DBG-Robots/PI5-HAT-relocator/production/bom.csv

Designator | Footprint | Quantity | Value | LCSC Part #
J1, J11, J13, J15, J3, J5, J7, J9 | PinHeader_1x02_P2.54mm_Vertical | 8 | Conn_01x02_Pin
J10, J12, J14, J16, J2, J4, J6, J8 | PinSocket_1x02_P2.54mm_Vertical | 8 | Conn_01x02_Socket
