DBG-Robots/PI5-HAT-relocator/PI5-HAT-relocator.step

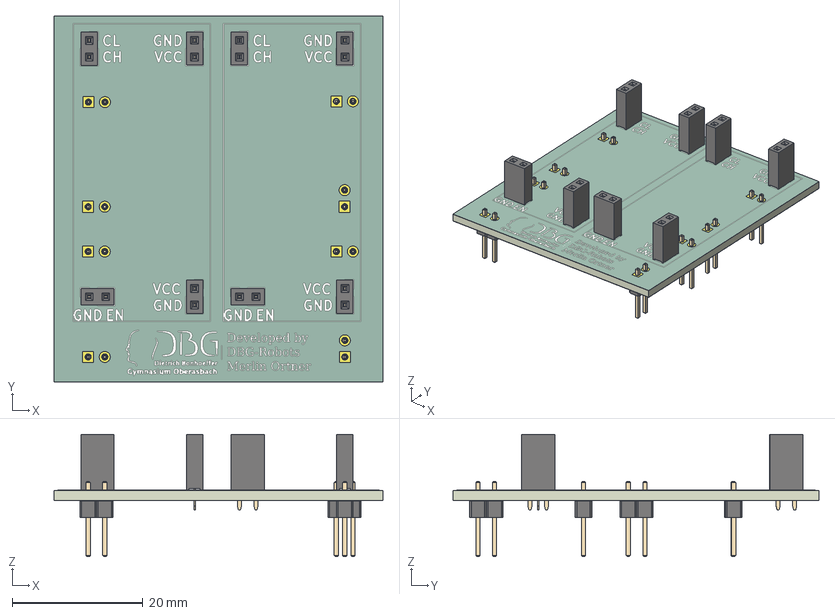
[picture p3: CAD file, 2026-10-31]
PI5-HAT-relocator.step
50.3 x 56.0 x 18.7 mm
PinSocket_1x02_P2.54mm_Vertical x 8
PinHeader_1x02_P254mm_Vertical x 8
MotorControllerHeader_copper
MotorControllerHeader_silkscreen x 2
MotorControllerHeader_soldermask x 2
MotorControllerHeader_PCB
