DBG-Robots/PI5-HAT-relocator/SketchPi2PHeaders.dxf

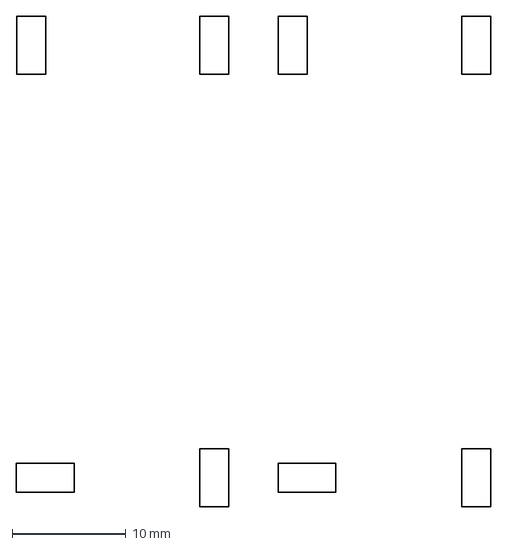
[picture p4: CAD file, 2026-10-30]
SketchPi2PHeaders.dxf
41.7 x 43.1 mm
