DBG-Robots/PI5-HAT-relocator/MotorControllerHeader.kicad_pcb

## KiCad design MotorControllerHeader.kicad_pcb (2026-10-31)

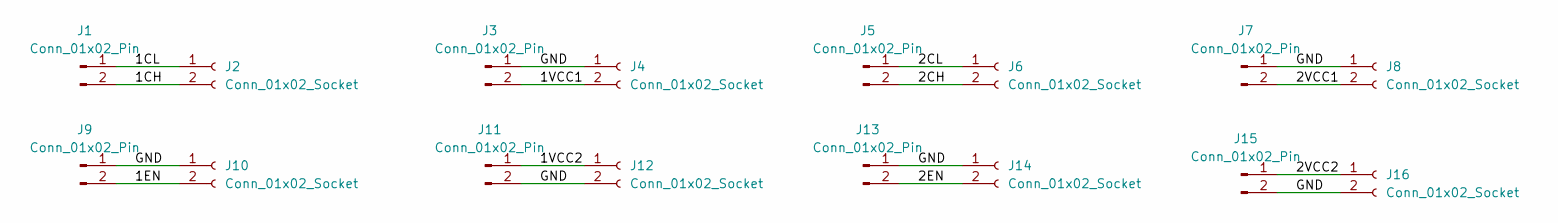
[picture p5: schematic MotorControllerHeader.kicad_sch]

Parts:
J1, J3, J5, J7, J9, J11, J13, J15: Conn_01x02_Pin; PinHeader_1x02_P2.54mm_Vertical
J2, J4, J6, J8, J10, J12, J14, J16: Conn_01x02_Socket; PinSocket_1x02_P2.54mm_Vertical

Connections:
/1CH: J1.2, J2.2
/1CL: J1.1, J2.1
/1EN: J9.2, J10.2
/1VCC1: J3.2, J4.2
/1VCC2: J11.1, J12.1
/2CH: J5.2, J6.2
/2CL: J5.1, J6.1
/2EN: J13.2, J14.2
/2VCC1: J7.2, J8.2
/2VCC2: J15.1, J16.1
/GND: J3.1, J4.1, J7.1, J8.1, J9.1, J10.1, J11.2, J12.2, J13.1, J14.1, J15.2, J16.2

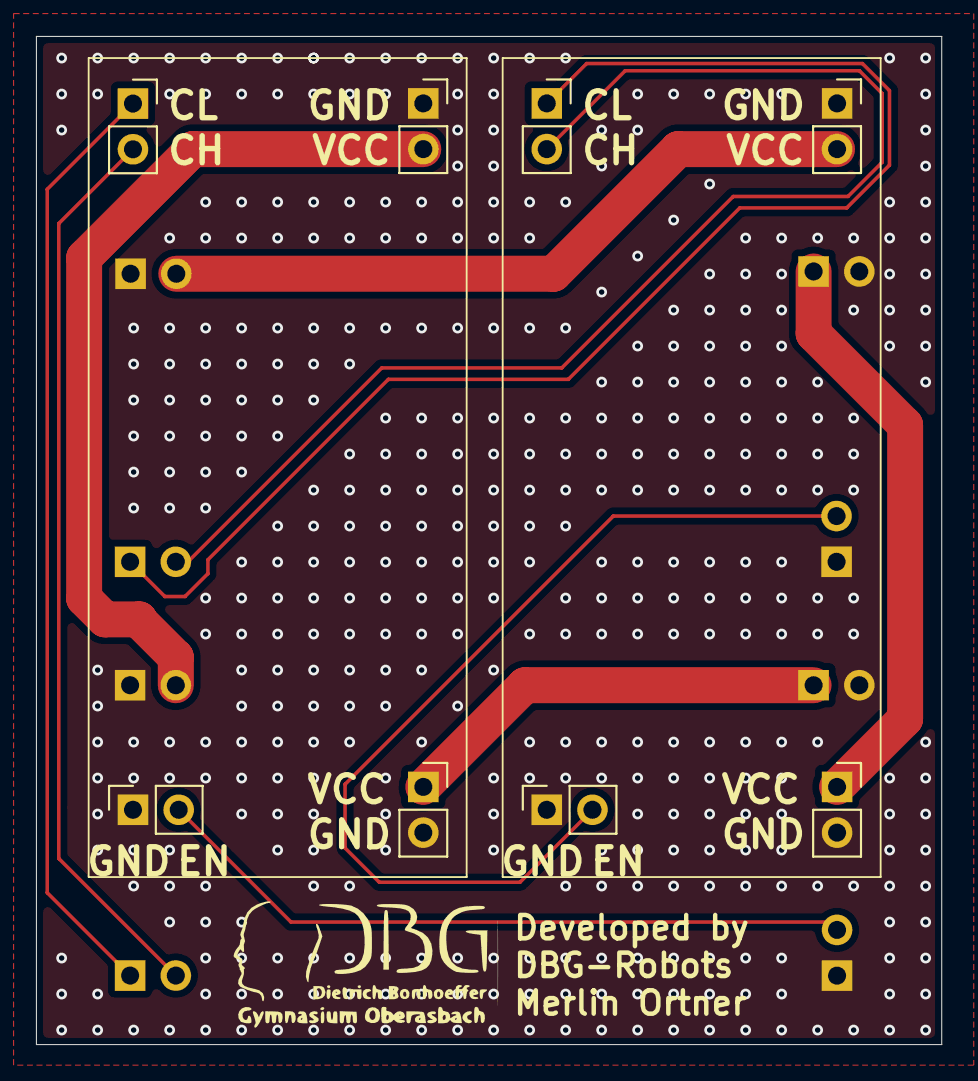
[picture p6: board MotorControllerHeader.kicad_pcb from above]

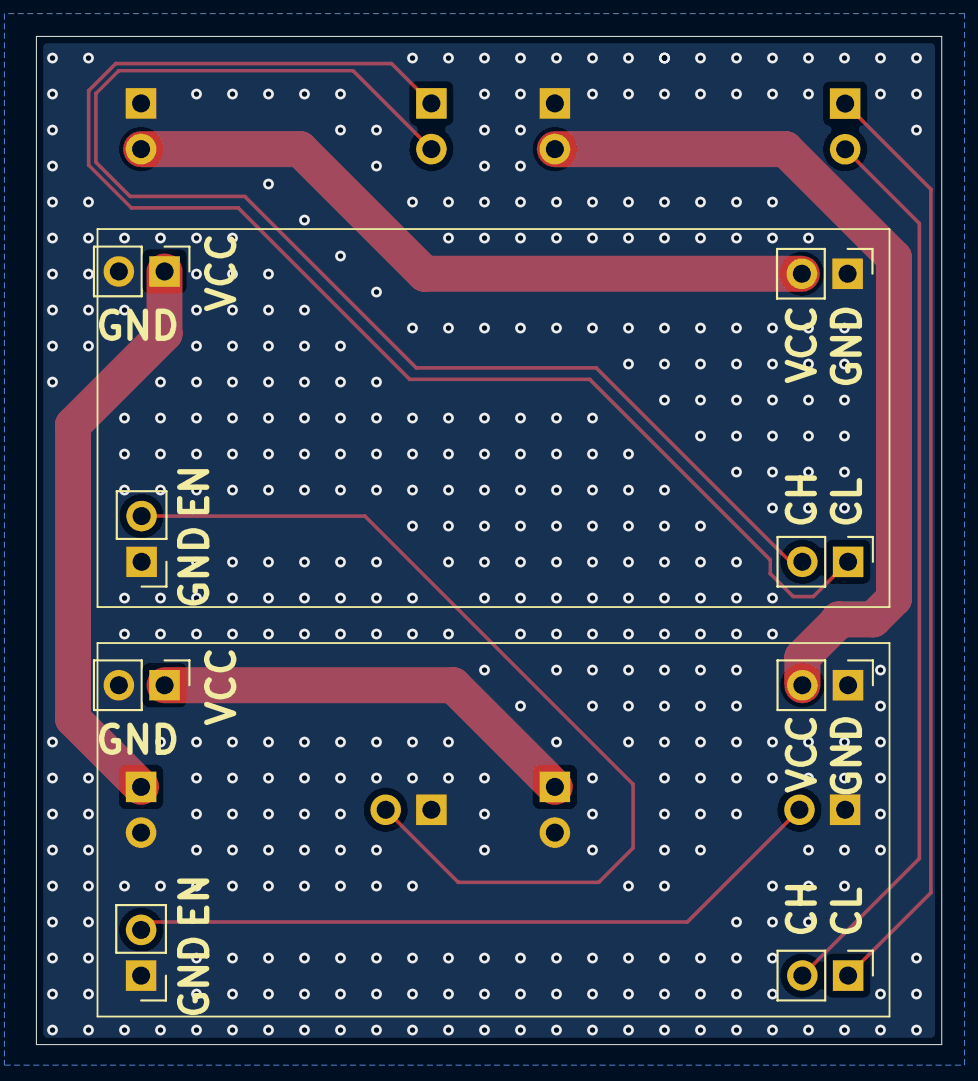
[picture p7: board MotorControllerHeader.kicad_pcb from below]

Board: 2 copper layers, 50.3 x 56.0 mm, 16 parts (8 on the bottom side), 11 nets.
