DBG-Robots/PI5-HAT-relocator/(commit log)

2026-10-31 Replanned Project: Removed ribbon cable; added female connectors on top and male connectors on bottom
    Excludes KiCad backups, autosaves, lock files and .kicad_prl via .gitignore.
2026-10-31 Finish board layout, add 3D STEP export and README screenshot
2026-10-31 Add German README and language switch links
2026-10-31 Update board layout, STEP export and production files
2026-11-11 README: pinout notes (6 of 16 pins used, headers kept for mechanical support), DRC/ERC results, link to Kinematics Kit Kim
2026-11-11 README: render of the Kinematics Kit stack, pinout corrected (4 of 8 connectors matter, VCC carries only Pi current)
2026-11-11 README: 3 of 8 connectors matter electrically, not 4
2026-11-11 README: we use the Kinematics Kit with Raspberry Pi HAT, Kim is the Ethernet-board variant
